HgA80/RoboLMS/BOM/WiringAndPowerDiagram.jpg

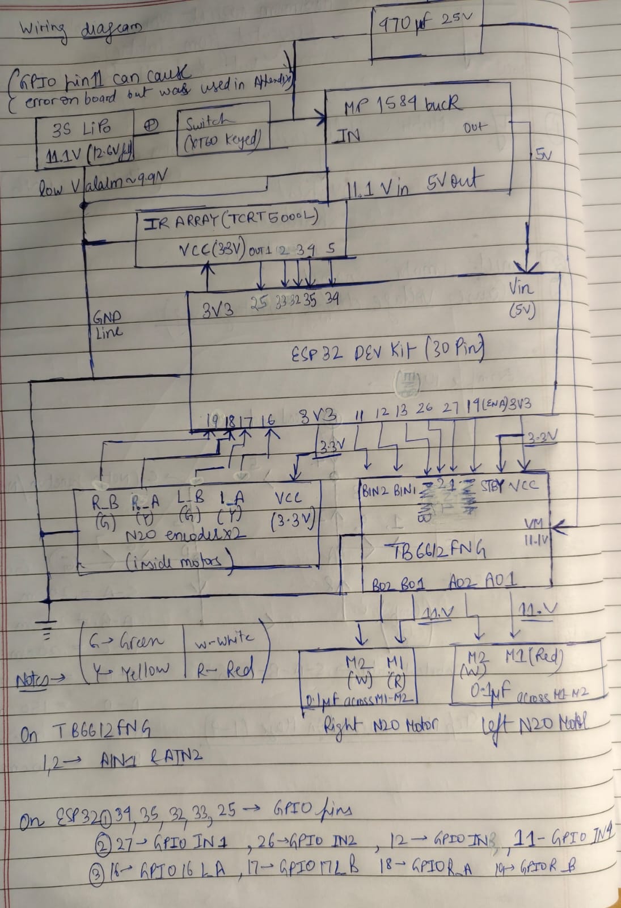
BOM/WiringAndPowerDiagram.jpg
