HgA80/RoboLMS/Docs/SampleMaze.jpg

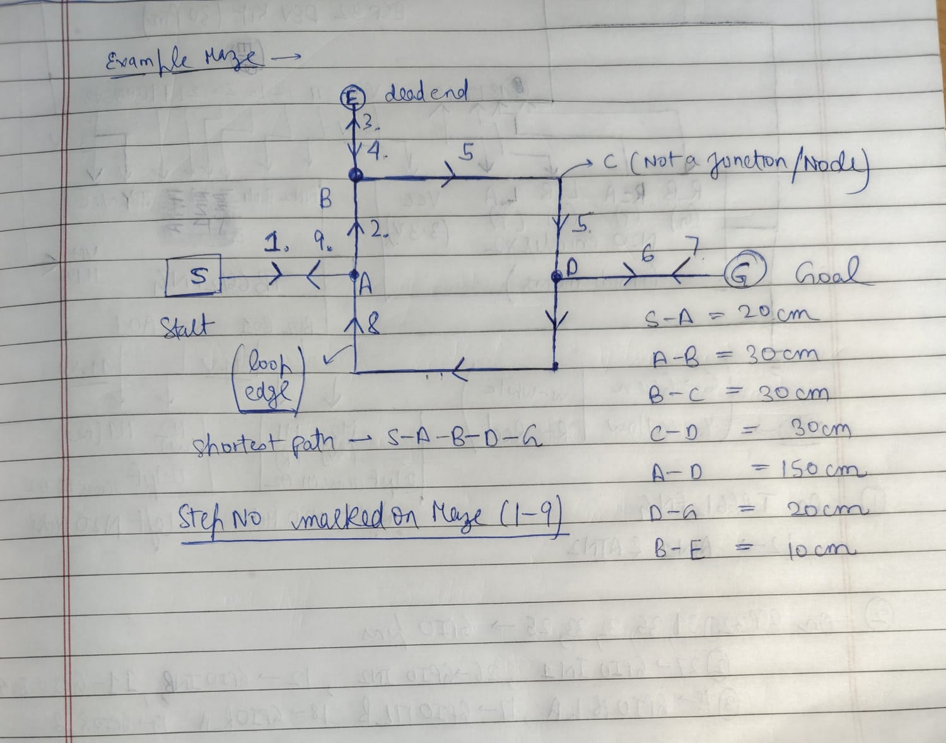
Docs/SampleMaze.jpg
